Willianlsz1/aquasense/docs/GUIA_MESTRE.md

# Guia mestre do AquaSense

O documento mestre é o texto do TCC **AquaSense_TCC_v6.7_ABNT** (21/10/2026, mantido
fora do repositório). Este guia liga as seções do TCC aos arquivos do código e separa o
que já foi comprovado do que é especificação ou plano.

## O que o TCC apresenta

| Parte do TCC | Situação | Onde está no repositório |
|---|---|---|
| Protótipo V1 — bancada (seção 4.1.1) | Montado e validado em 12/09/2026 | `firmware/aquasense_hc_sr04/`, [validação](VALIDACAO_BANCADA_2026-09-12.md) |
| Protótipo V2 — tubo de acrílico (seção 4.1.2) | Montado, conforme o TCC; falta calibrar o sensor para iniciar os ensaios com água | [roteiro de ensaios](ENSAIOS_V2.md) |
| UCT comercial (seções 4.2 a 4.5) | Especificação; não montada | `firmware/referencia_uct/` (referência, sem ensaio) |
| Software e nuvem (seção 4.6) | Publicado e com testes locais | `cloudflare-worker/`, `index.html`, `relatorio.html`, `assets/` |
| Empresa e identidade visual (capítulo 2 e Apêndice E) | WIM é empresa fictícia da equipe; marca aplicada ao painel | `index.html` |
| Manual, manutenção e finanças (capítulos 5 a 7, 9 e 10) | Somente no texto do TCC | — |
| Mercado (capítulo 8 e Apêndice D) | Fontes conferidas; questionário não aplicado | [validação de mercado](VALIDACAO_MERCADO.md) |

Os protótipos e a UCT compartilham a lógica do firmware (fila, envio, faixas),
o servidor e o painel. O protótipo usa um sketch único; a UCT, os fontes em
`firmware/referencia_uct/`. Mudam o sensor, a comunicação, a energia e a proteção.

## Cenário financeiro do TCC

O cenário de referência é a operação completa de cerca de 100 pontos (premissa P2,
seção 9.3): investimento de R$ 750.000, economia líquida de R$ 425.600 por ano (71% do
custo atual) e payback de cerca de 21 meses. A implantação pode começar por um piloto
de 20 pontos: R$ 150.000, R$ 85.120 por ano e o mesmo payback (seção 9.3.2).

Só o custo da ordem de R$ 600 mil por ano vem do desafio. O número de pontos, o preço e
a composição do custo são estimativas dos autores, e nada disso foi medido em campo.

## Medição e escala do V1

O HC-SR04 mede distância até um alvo. O firmware usa a mediana de cinco tentativas
e converte a distância em nível equivalente: `max(0, 40 - distancia_cm) * 0,5`.
Distância de 20 cm corresponde a 10 m didáticos. O valor exibido não é uma coluna
real de dez metros nem uma medição direta de poropressão.

Faixas: NORMAL abaixo de 12 m, ATENÇÃO a partir de 12 m e CRÍTICO a partir de 15 m,
com histerese de 0,2 m na descida. São valores de demonstração; em campo, os limites
de cada instrumento vêm da geotecnia do cliente.

Ausência de eco válido é FALHA SENSOR: o último valor pode servir de referência,
mas não é enviado como amostra nova.

## Cadeia de dados

1. O ESP32 lê o sensor, classifica a faixa e prepara o envio.
2. `POST /ingest` autentica o dispositivo e valida o conteúdo.
3. O D1 guarda as leituras com horário de medição (`ts`) e de recepção (`recebido_em`).
4. A cada minuto, o motor de alertas avalia nível, taxa de variação e comunicação;
   estados e eventos ficam no KV.
5. O painel consulta `/ultimos`, `/dados`, `/alerts` e `/config` a cada dez segundos.

O frescor usa a recepção; sem recepção por mais de 120 s, o ponto aparece como
SEM SINAL. A taxa de variação usa o horário da medição.

## Painel web

- Resumo no topo (frase e indicadores de alerta, sem sinal e última recepção),
  calculado das últimas leituras. Leitura antiga conta como SEM SINAL; falha da
  API aparece como "não confirmado", nunca como rede normal.
- Tabela de instrumentos por prioridade: nível sobre a escala com os limites,
  folga até a atenção, tendência de 24 h, taxa, recepção e disponibilidade.
  Gráfico da rede, mapa ilustrativo e ocorrências recentes.
- Instrumento: quadro de incidente em atenção/crítico, comunicação, cadastro
  editável (salvo no navegador) e som do alarme crítico com opção de silenciar.
- Leitura atual, origem do dado, última recepção e condição do ponto.
- Gráficos de 24h, 7d, 30d e 90d com média, pico e lacunas visíveis.
- Eventos do servidor (até 50 da rede) como única lista de ocorrências.
- Exportação CSV, Excel e relatório PDF (`relatorio.html`); o PDF fica bloqueado
  na simulação.
- Demonstração só no endereço `?demo`, identificada na tela e nas exportações.
  O endereço normal não tem simulação; falha da API mostra indisponibilidade.
- Tema claro e escuro, com a preferência salva.

## O que foi comprovado

| Evidência | Data | Limite |
|---|---|---|
| Faixas, falha de eco, recuperação e HTTP 204 na bancada | 12/09/2026 | Sem régua: não mede exatidão. |
| OLED exibiu FALHA SENSOR | 12/09/2026 | O display apagou depois, no mesmo dia; substituído pelo TFT. |
| TFT ST7789 com as quatro faixas e tela de campo | 27/09/2026 | Conferência por fotos, sem água no tubo. |
| Queda de rede (12 min) e perda de sinal (18 min) | 27/09/2026 | Bancada; ~50 s perdidos no instante da queda. [Ensaios](ENSAIOS_V2.md). |
| HTTPS com certificado do servidor validado | 27/09/2026 | Depende de NTP e das raízes gravadas no firmware. |
| Painel e Worker publicados | 13/09/2026 | Publicado não significa disponível hoje. A cota diária do D1 já bloqueou consultas. |
| Testes automatizados | 06/11/2026 | 47/47 aprovados localmente (`npm test`). O TCC v6.7 cita 49: dois testes saíram em 14/10/2026 com o gerador do sketch único. |

## Limites conhecidos

- O buffer do V1 fica em RAM: até 120 envios, cerca de 20 minutos. Quando lota,
  descarta o mais antigo; um reinício perde as pendências. A UCT prevê flash.
- O protótipo não usa LEDs nem buzzer: o estado aparece no display TFT e no painel.
- Dados brutos ficam retidos por 180 dias; dias anteriores viram resumos diários,
  ainda sem consulta no painel.
- Os índices da migração 0004 reduziram as consultas ao D1 no código; a economia
  real em produção ainda não foi medida.

## Como demonstrar

Apresentar o problema, mostrar a distância física e a escala, mover o alvo (ou a
água, no V2) pelas faixas, consultar histórico e exportação e explicar SEM SINAL e
simulação. Registrar data, firmware e o que foi observado.
