Willianlsz1/aquasense/docs/CRITERIOS_UI_OPERACIONAL.md

# AquaSense — critérios do painel operacional

## Escopo

Aplicação no painel principal (`index.html`). Preserva mapa, gráficos, histórico e
exportações. O sistema é um protótipo didático; esta revisão não certifica conformidade
com normas nem transforma a leitura de um instrumento em avaliação de segurança.

## Referências e decisões

- [ISA-101 — visão pública da norma](https://www.isa.org/standards-and-publications/isa-standards/isa-101-standards):
  hierarquia e compreensão pelo operador. Rede primeiro, instrumento selecionado,
  leitura e tendência, condição e registros. Superfícies neutras e destaque das exceções.
- [ISA-18 — gestão de alarmes](https://www.isa.org/standards-and-publications/isa-standards/isa-18-series-of-standards):
  separar condição presente de registros históricos. As ocorrências da sessão não são
  uma lista de alarmes ativos. Não há implementação completa de reconhecimento,
  supressão, racionalização ou ciclo de vida de alarmes.
- [Vista Data Vision — interface](https://help.vistadatavision.com/web-interface):
  referência funcional para mapa, tendências, registros e exportações.
- [Sixense — plataformas de monitoramento](https://www.sixense-group.com/en/services/monitoring-testing/monitoring-software-platform):
  referência para leitura conjunta de localização, dados e eventos.

As páginas públicas orientam o projeto; não substituem o texto integral das normas.
Não se adotam percentuais de cor ou taxas de alarme como exigências universais.

## Comportamentos verificáveis

1. O endereço normal só usa a fonte real e não oferece simulação. Erro de API não
   aciona simulação.
2. A demonstração existe apenas em `index.html?demo` (decisão de 23/10/2026: separar
   demonstração de operação). Fica identificada na faixa, no status e nas
   exportações; o PDF real fica bloqueado nesse modo.
3. Trocar a fonte limpa leituras e séries anteriores. Falha de consulta deixa a condição
   atual sem confirmação e identifica valores anteriores como referência.
4. As posições do mapa são ilustrativas. Decisão da equipe (25/09/2026): o painel
   usa linguagem de produto, sem avisos de "didático"; a indicação de SIMULAÇÃO,
   SEM SINAL e "não confirmado" permanece obrigatória.
5. O histórico do servidor consulta `/alerts`: até 50 registros da rede, filtrados
   pelo instrumento selecionado. Não equivale a arquivo completo ou imutável de auditoria.
6. CSV de alertas identifica origem, filtro, horário local/UTC e eventual cache.
7. CSV/Excel de leituras usam os intervalos disponíveis; não são anunciados como
   exportação integral de amostras brutas.
8. O gráfico posiciona dados no tempo, interrompe a linha nas lacunas e não preenche
   essas lacunas com área colorida. Períodos longos incluem data nos rótulos.
9. A visão geral é uma tabela ordenada por prioridade. O nível aparece sobre uma
   escala com faixas neutras e limites marcados; a cor só aparece fora do normal.
10. Ocorrências: no monitoramento real, só os registros do servidor; na demonstração,
    as transições da sessão. Não há lista paralela de "eventos da sessão".
11. Instrumento em atenção ou crítico abre um quadro de incidente (desde quando, pico,
    tendência, vizinhos e o que fazer). Não há reconhecimento de alarme com registro:
    isso exige login e gravação no servidor.
12. Crítico toca um som no navegador a cada 20 s, com opção de silenciar. Não substitui
    aviso fora da tela (e-mail, mensagem), que o projeto não implementa.
13. Nome e cadastro do instrumento são editáveis e ficam salvos no navegador. O código
    enviado pela UCT não muda. Limites seguem iguais para todos os instrumentos.

## Limitações

Acesso local à API e aos mapas depende da rede e das permissões de origem do servidor.
Testes locais e simulação não validam bancada, serviço publicado ou instrumentação industrial.
Limiares precisam ser definidos pelo responsável pelo caso de uso. Firmware/OLED não
fazem parte desta revisão. A versão revisada foi publicada em 13/09/2026.

## Conferência em 13/09/2026

- `/ultimos` respondeu HTTP 200. O cabeçalho `Access-Control-Allow-Origin` permite
  `https://willianlsz1.github.io`, não a origem da prévia local. Isso explica a falha
  de acesso no navegador local; não foi necessário alterar CORS em produção.
- Uma prévia temporária, restrita a `127.0.0.1`, intermediou somente consultas GET
  aos endpoints existentes. Os arquivos do produto mantêm a URL original da API.
- O painel consultou os dados reais e exibiu `SEM SINAL`: última recepção de PZ-01
  em 12/09/2026 às 17:09:22, horário local. Não houve comprovação de nova medição física.
- A consulta retornou 50 eventos para PZ-01. Selecionar PZ-02 exibiu zero eventos
  dentro desse recorte, sem afirmar ausência de eventos fora dos últimos 50.
- Testes de exportação verificam 72 intervalos completos, classificação pelo máximo
  mesmo com média normal, e identificação de simulação em CSV e Excel.
