Willianlsz1/aquasense/docs/img/painel_api_indisponivel.png

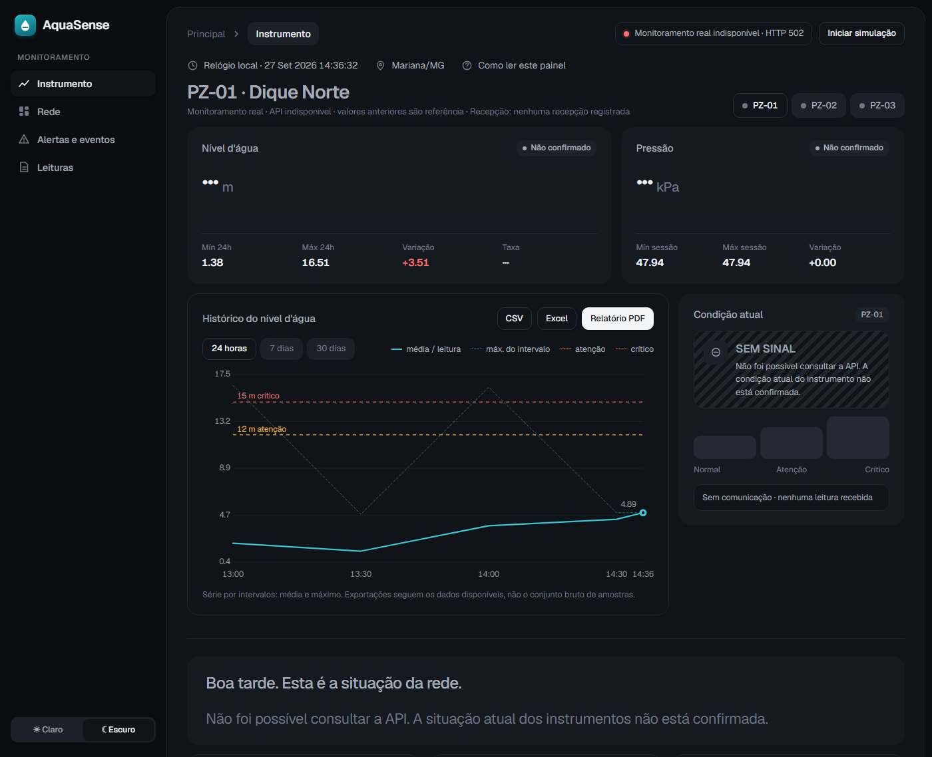
docs/img/painel_api_indisponivel.png
