Willianlsz1/aquasense/docs/img/painel_eventos.png

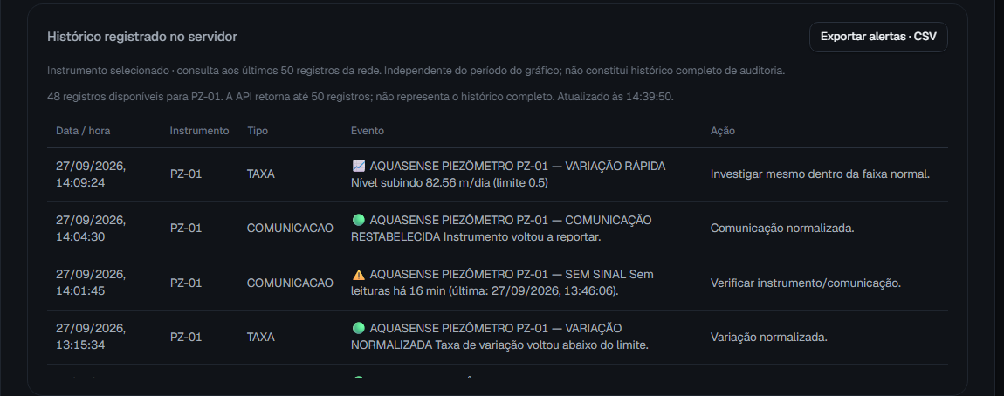
docs/img/painel_eventos.png
