Willianlsz1/aquasense/docs/img/painel_rede.png

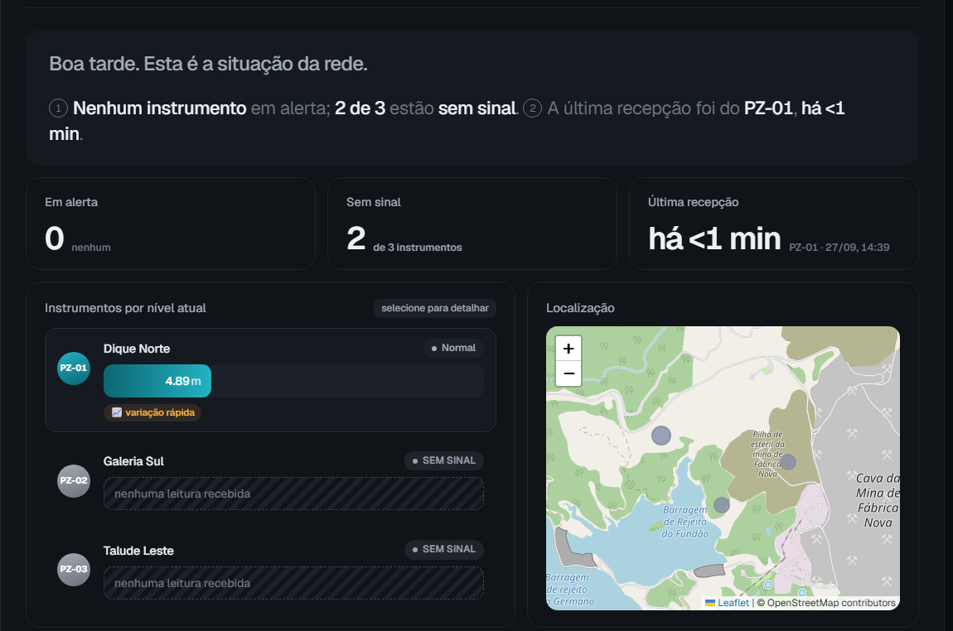
docs/img/painel_rede.png
