Willianlsz1/aquasense/firmware/aquasense_hc_sr04/aquasense_hc_sr04.ino

// AQUASENSE — protótipo V1/V2: ESP32 + HC-SR04 + TFT ST7789
// Lê o nível a cada 1 s, mostra na tela e no Serial, e envia ao servidor a cada 10 s.
// Sem rede, guarda até 120 leituras (~20 min) e envia quando a rede volta.
//
// Arduino IDE: placa "ESP32 Dev Module"; bibliotecas "Adafruit GFX" e
// "Adafruit ST7735 and ST7789". Preencha as credenciais abaixo SÓ na sua cópia
// local e não publique o arquivo preenchido (contém senha e chave).

#include <SPI.h>
#include <Adafruit_GFX.h>
#include <Adafruit_ST7789.h>
#include <WiFi.h>
#include <HTTPClient.h>
#include <WiFiClientSecure.h>
#include <time.h>

// ===== CREDENCIAIS (preencha antes de gravar) =====
#define WIFI_SSID     "SUA_REDE_WIFI"
#define WIFI_PASS     "SUA_SENHA_WIFI"
#define SERVER_URL    "https://piezometro-worker.SEU-SUBDOMINIO.workers.dev/ingest"
#define DEVICE_KEY    "troque-esta-chave"   // a mesma DEVICE_KEY do Worker
#define PIEZOMETRO_ID "PZ-01"

// ===== FAIXAS DE ALERTA (m) =====
#define NIVEL_ATENCAO 12.0   // a partir daqui: ATENCAO
#define NIVEL_CRITICO 15.0   // a partir daqui: CRITICO

// ===== SENSOR HC-SR04 =====
#define PIN_TRIG 5
#define PIN_ECHO 18             // ECHO é 5 V: manter o divisor 1k/2k
#define ALTURA_REF_CM   40.0    // distância do sensor ao nível zero
#define ESCALA_M_POR_CM  0.5    // escala didática: 1 cm = 0,5 m
#define DIST_MIN_CM  3.0
#define DIST_MAX_CM  400.0

// ===== TELA TFT ST7789 (SPI, 320x240 deitada) =====
#define TFT_SCK  14   // pino SCK da tela
#define TFT_MOSI 13   // pino SDA da tela
#define TFT_CS   25
#define TFT_DC   27
#define TFT_RST  26
#define TFT_LARGURA 320

// ===== TEMPOS =====
#define INTERVALO_LEITURA   1000UL    // 1 s
#define INTERVALO_ENVIO     10000UL   // 10 s
#define INTERVALO_NTP       300000UL  // ressincroniza o relógio a cada 5 min
#define INTERVALO_RECONEXAO 60000UL   // insiste no Wi-Fi a cada 1 min
#define FUSO_HORARIO_SEG    (-3 * 3600)  // hora de Brasília na tela; o envio usa UTC
#define BUFFER_MAX          120       // ~20 min de leituras sem rede

// Faixas: também escolhem a cor da tarja na tela
enum Faixa { NORMAL, ATENCAO, CRITICO, FALHA };

// ===== CERTIFICADOS RAIZ (valida o servidor HTTPS) =====
static const char CA_RAIZES[] = R"PEM(
-----BEGIN CERTIFICATE-----
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
-----END CERTIFICATE-----
-----BEGIN CERTIFICATE-----
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
/q4AaOeMSQ+2b1tbFfLn
-----END CERTIFICATE-----
-----BEGIN CERTIFICATE-----
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
bP6MvPJwNQzcmRk13NfIRmPVNnGuV/u3gm3c
-----END CERTIFICATE-----
-----BEGIN CERTIFICATE-----
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
6WLAYv7YTVWW4tAR+kg0Eeye7QUd5MjWHYbL
-----END CERTIFICATE-----
-----BEGIN CERTIFICATE-----
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
-----END CERTIFICATE-----
-----BEGIN CERTIFICATE-----
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
-----END CERTIFICATE-----
)PEM";

// ===== ESTADO =====
SPIClass spiTela(HSPI);
Adafruit_ST7789 tft(&spiTela, TFT_CS, TFT_DC, TFT_RST);

float nivelM = 0;              // último nível válido (m)
float distanciaCm = -1;        // última distância medida; -1 = sem eco
bool leituraValida = false;    // a leitura deste ciclo veio do sensor?
bool jaTeveLeitura = false;    // houve alguma leitura válida desde o início?
Faixa faixa = FALHA;

bool ntpOk = false;
int ultimoCodigoHttp = 0;      // 0 = ainda não enviou; 204 = aceito; <0 = sem conexão
unsigned long ultimoEnvioOkMs = 0;
unsigned long ultimaLeitura = 0, ultimoEnvio = 0, ultimoNtp = 0, ultimaReconexao = 0;

String fila[BUFFER_MAX];
int filaCount = 0;

// ===== SENSOR =====
float medirDistanciaCm() {
  digitalWrite(PIN_TRIG, LOW);
  delayMicroseconds(2);
  digitalWrite(PIN_TRIG, HIGH);
  delayMicroseconds(10);
  digitalWrite(PIN_TRIG, LOW);
  unsigned long duracao = pulseIn(PIN_ECHO, HIGH, 30000UL);  // espera até 30 ms
  return duracao / 58.0;                                     // µs -> cm (0 = sem eco)
}

// Mediana de 5 tentativas, ignorando as fora da faixa útil. -1 = nenhuma válida.
float medirMedianaCm() {
  float v[5];
  int n = 0;
  for (int i = 0; i < 5; i++) {
    float d = medirDistanciaCm();
    if (d >= DIST_MIN_CM && d <= DIST_MAX_CM) v[n++] = d;
    delay(30);
  }
  if (n == 0) return -1;
  for (int i = 1; i < n; i++)            // ordena (poucos valores)
    for (int j = i; j > 0 && v[j - 1] > v[j]; j--) {
      float t = v[j]; v[j] = v[j - 1]; v[j - 1] = t;
    }
  return v[n / 2];
}

void lerSensor() {
  distanciaCm = medirMedianaCm();
  leituraValida = distanciaCm > 0;
  if (!leituraValida) {      // falha: mantém o último nível, mas não o envia como novo
    faixa = FALHA;
    return;
  }
  nivelM = max(0.0, ALTURA_REF_CM - distanciaCm) * ESCALA_M_POR_CM;
  jaTeveLeitura = true;
  if (nivelM < NIVEL_ATENCAO) faixa = NORMAL;
  else if (nivelM < NIVEL_CRITICO) faixa = ATENCAO;
  else faixa = CRITICO;
}

// ===== REDE =====
void conectarWiFi() {
  Serial.print("Conectando ao Wi-Fi \"" WIFI_SSID "\"");
  WiFi.setAutoReconnect(true);
  WiFi.begin(WIFI_SSID, WIFI_PASS);
  unsigned long inicio = millis();
  while (WiFi.status() != WL_CONNECTED && millis() - inicio < 15000) {
    delay(500);
    Serial.print(".");
  }
  if (WiFi.status() == WL_CONNECTED) {
    Serial.print(" OK! IP: ");
    Serial.println(WiFi.localIP());
  } else {
    Serial.println(" FALHOU - segue medindo e guardando na fila.");
  }
}

void sincronizarNTP() {
  if (WiFi.status() != WL_CONNECTED) return;
  Serial.print("Sincronizando relogio (NTP)");
  configTime(0, 0, "pool.ntp.org");
  unsigned long inicio = millis();
  while (time(nullptr) < 1000000000 && millis() - inicio < 10000) {
    delay(500);
    Serial.print(".");
  }
  ntpOk = time(nullptr) >= 1000000000;
  Serial.println(ntpOk ? " OK!" : " FALHOU - envio sem horario local.");
}

// Guarda a leitura atual na fila; se cheia, descarta a mais antiga.
void guardarNaFila() {
  char item[96];
  if (ntpOk)
    snprintf(item, sizeof(item), "{\"piezometro\":\"" PIEZOMETRO_ID "\",\"nivel_agua\":%.3f,\"ts\":%ld}",
             nivelM, (long)time(nullptr));
  else
    snprintf(item, sizeof(item), "{\"piezometro\":\"" PIEZOMETRO_ID "\",\"nivel_agua\":%.3f}", nivelM);

  if (filaCount >= BUFFER_MAX) {
    for (int i = 1; i < BUFFER_MAX; i++) fila[i - 1] = fila[i];
    filaCount = BUFFER_MAX - 1;
    Serial.println("Fila cheia - leitura mais antiga descartada");
  }
  fila[filaCount++] = item;
}

// Envia a fila inteira num único POST; só esvazia se o servidor aceitar (HTTP 204).
void enviarFila() {
  if (filaCount == 0) return;
  if (WiFi.status() != WL_CONNECTED) {
    Serial.printf("Wi-Fi offline - %d leitura(s) na fila\n", filaCount);
    if (millis() - ultimaReconexao >= INTERVALO_RECONEXAO) {
      ultimaReconexao = millis();
      WiFi.reconnect();
    }
    return;
  }
  if (!ntpOk) sincronizarNTP();  // a rede voltou: tenta recuperar o relógio

  String corpo = "{\"leituras\":[";
  for (int i = 0; i < filaCount; i++) {
    if (i > 0) corpo += ",";
    corpo += fila[i];
  }
  corpo += "]}";

  WiFiClientSecure cliente;
  cliente.setCACert(CA_RAIZES);
  cliente.setHandshakeTimeout(5);  // s: rede ruim não pode travar a medição por muito tempo
  HTTPClient http;
  http.begin(cliente, SERVER_URL);
  http.addHeader("Content-Type", "application/json");
  http.addHeader("X-Device-Key", DEVICE_KEY);
  http.setConnectTimeout(3000);
  http.setTimeout(5000);

  ultimoCodigoHttp = http.POST(corpo);
  if (ultimoCodigoHttp == 204) {
    ultimoEnvioOkMs = millis();
    Serial.printf("Servidor: %d leitura(s) enviadas (HTTP 204)\n", filaCount);
    filaCount = 0;
  } else {
    Serial.printf("Servidor: falha (HTTP %d) - %d leitura(s) na fila\n", ultimoCodigoHttp, filaCount);
  }
  http.end();
}

// ===== TELA =====
// Escreve uma linha, completando com espaços para apagar o texto anterior.
void linha(const char* texto, uint8_t tamanho, int16_t y, uint16_t cor, uint16_t fundo) {
  char buf[32];
  snprintf(buf, sizeof(buf), "%-25.25s", texto);
  tft.setTextSize(tamanho);
  tft.setTextColor(cor, fundo);
  tft.setCursor(8, y);
  tft.print(buf);
}

void desenharFundo() {
  tft.fillScreen(ST77XX_BLACK);
  tft.fillRect(0, 0, TFT_LARGURA, 32, ST77XX_BLUE);
}

void mostrarTelaInicio() {
  tft.fillScreen(ST77XX_BLACK);
  tft.setTextColor(ST77XX_CYAN);
  tft.setTextSize(4);
  tft.setCursor(52, 60);
  tft.print("AquaSense");
  tft.setTextColor(ST77XX_WHITE);
  tft.setTextSize(2);
  tft.setCursor(64, 120);
  tft.print("Nivel de agua em");
  tft.setCursor(94, 144);
  tft.print("piezometros");
  tft.setCursor(88, 196);
  tft.print("Iniciando...");
  delay(2000);
  desenharFundo();
}

// Tarja inferior colorida; só redesenha quando a faixa muda (evita piscar).
void mostrarTarja() {
  static int faixaDesenhada = -1;
  if (faixa == faixaDesenhada) return;
  faixaDesenhada = faixa;

  const char* rotulo = "NORMAL";
  uint16_t fundo = ST77XX_GREEN, cor = ST77XX_BLACK;
  if (faixa == ATENCAO)      { rotulo = "ATENCAO";      fundo = ST77XX_YELLOW; }
  else if (faixa == CRITICO) { rotulo = "CRITICO!";     fundo = ST77XX_RED;     cor = ST77XX_WHITE; }
  else if (faixa == FALHA)   { rotulo = "FALHA SENSOR"; fundo = ST77XX_MAGENTA; cor = ST77XX_WHITE; }

  tft.fillRect(0, 160, TFT_LARGURA, 80, fundo);
  tft.setTextSize(4);  // 24 px por caractere
  tft.setTextColor(cor);
  tft.setCursor(max(0, (TFT_LARGURA - (int)strlen(rotulo) * 24) / 2), 184);
  tft.print(rotulo);
}

void mostrarTela() {
  char buf[40];

  char hora[9] = "--:--:--";
  if (ntpOk) {
    time_t t = time(nullptr) + FUSO_HORARIO_SEG;
    struct tm tmHora;
    gmtime_r(&t, &tmHora);
    strftime(hora, sizeof(hora), "%H:%M:%S", &tmHora);
  }
  snprintf(buf, sizeof(buf), "%-16s%s", PIEZOMETRO_ID " AQUASENSE", hora);
  linha(buf, 2, 9, ST77XX_WHITE, ST77XX_BLUE);

  // Em falha, mostra o último nível como "Ultimo", nunca como medição atual
  if (!jaTeveLeitura) snprintf(buf, sizeof(buf), "Nivel: ---");
  else snprintf(buf, sizeof(buf), leituraValida ? "Nivel: %.2f m" : "Ultimo: %.2f m", nivelM);
  linha(buf, 3, 42, ST77XX_WHITE, ST77XX_BLACK);

  if (leituraValida) snprintf(buf, sizeof(buf), "Sensor: %.1f cm", distanciaCm);
  else snprintf(buf, sizeof(buf), "Sensor: sem eco");
  linha(buf, 2, 78, ST77XX_CYAN, ST77XX_BLACK);

  snprintf(buf, sizeof(buf), "Limites: %.0f / %.0f m", NIVEL_ATENCAO, NIVEL_CRITICO);
  linha(buf, 2, 102, ST77XX_CYAN, ST77XX_BLACK);

  // Comunicação: amarelo quando há problema
  bool problema = true;
  long rssi = WiFi.RSSI();
  if (WiFi.status() != WL_CONNECTED)
    snprintf(buf, sizeof(buf), "SEM WI-FI  Fila %d %dmin", filaCount, filaCount * 10 / 60);
  else if (ultimoCodigoHttp < 0)
    snprintf(buf, sizeof(buf), "SEM SERVIDOR  Fila %d", filaCount);
  else if (ultimoCodigoHttp != 0 && ultimoCodigoHttp != 204)
    snprintf(buf, sizeof(buf), "ERRO SERV %d  Fila %d", ultimoCodigoHttp, filaCount);
  else {
    problema = false;
    unsigned long idade = (millis() - ultimoEnvioOkMs) / 1000;
    if (ultimoCodigoHttp == 0) snprintf(buf, sizeof(buf), "WiFi %lddBm  Aguardando", rssi);
    else if (idade < 100)      snprintf(buf, sizeof(buf), "WiFi %lddBm  Envio OK %lus", rssi, idade);
    else                       snprintf(buf, sizeof(buf), "WiFi %lddBm  Envio OK %lum", rssi, idade / 60);
  }
  linha(buf, 2, 130, problema ? ST77XX_YELLOW : ST77XX_WHITE, ST77XX_BLACK);

  mostrarTarja();
}

// ===== SERIAL =====
void mostrarSerial() {
  Serial.println("---------------------------------------");
  if (leituraValida) {
    Serial.printf("Nivel: %.2f m   Distancia: %.1f cm\n", nivelM, distanciaCm);
  } else {
    Serial.println("FALHA SENSOR - sem eco; leitura nao sera enviada.");
    if (jaTeveLeitura) Serial.printf("Ultimo nivel conhecido: %.2f m\n", nivelM);
    else Serial.println("Nenhuma leitura valida desde o inicio");
  }
  const char* status[] = {"NORMAL", "ATENCAO", "CRITICO", "FALHA SENSOR"};
  Serial.printf("Status: %s   Fila: %d leitura(s)\n", status[faixa], filaCount);
}

// ===== INÍCIO E REPETIÇÃO =====
void setup() {
  Serial.begin(115200);
  delay(1000);
  Serial.println("=== AQUASENSE - instrumento " PIEZOMETRO_ID " ===");

  pinMode(PIN_TRIG, OUTPUT);
  pinMode(PIN_ECHO, INPUT);
  digitalWrite(PIN_TRIG, LOW);

  spiTela.begin(TFT_SCK, -1, TFT_MOSI, TFT_CS);
  tft.init(240, 320);
  tft.invertDisplay(false);  // este módulo mostrava as cores invertidas
  tft.setRotation(1);
  tft.setTextWrap(false);
  mostrarTelaInicio();

  conectarWiFi();
  sincronizarNTP();
  ultimoNtp = millis();
  Serial.println("Monitoramento iniciado.");
}

void loop() {
  unsigned long agora = millis();

  if (agora - ultimaLeitura >= INTERVALO_LEITURA) {
    ultimaLeitura = agora;
    lerSensor();
    mostrarSerial();
    mostrarTela();
  }

  if (agora - ultimoEnvio >= INTERVALO_ENVIO) {
    ultimoEnvio = agora;
    if (leituraValida) guardarNaFila();
    enviarFila();  // pode esperar alguns segundos se a rede estiver ruim
  }

  if (agora - ultimoNtp >= INTERVALO_NTP) {
    ultimoNtp = agora;
    sincronizarNTP();
  }
}
