Willianlsz1/aquasense/(commit log)

2026-07-28 docs: deixa o README apresentável com fotos da demo e seções de segurança e autor
    - Fotos reais do protótipo de bancada e do dashboard durante a demonstração de 28/07
    - Estado do projeto atualizado com a demo em vídeo
    - Nova seção Segurança: onde vivem os segredos e por quê
    - Nova seção Autor com contato e posicionamento honesto do protótipo
    - Árvore de estrutura atualizada com docs/img/
2026-07-28 docs: atualiza referências do nome do repositório para aquasense
    O repositório foi renomeado de piezometro-teste para aquasense no GitHub.
    Links antigos do repositório redirecionam automaticamente; a URL do GitHub
    Pages muda para /aquasense.
2026-07-28 segurança: restringe CORS à origem do dashboard publicado
    ALLOWED_ORIGIN passa de "*" para https://willianlsz1.github.io, alinhando o
    Worker com o que a seção de Segurança do README documenta. Não afeta o ESP32
    (dispositivos não passam por CORS) nem os endpoints em si — só restringe qual
    origem de navegador pode ler a API.
2026-08-22 docs: esclarece contrato de dados stale
2026-08-22 docs: planeja remoção de canais externos
2026-08-22 test: define contrato de telemetria stale
2026-08-22 chore: remove configuração de Telegram e Twilio
2026-08-22 fix: não deriva indicadores de leitura stale
2026-08-22 fix: preserva borda de taxa durante perda de sinal
2026-09-09 docs: define fluxo simples de trabalho do TCC
2026-09-11 fix(firmware): signal sensor failure in HC-SR04 prototype
    [piezometro_core.h, sketch_demo_hc_sr04.ino, sketch_uct_4a20ma.ino, tela.h]
2026-09-12 fix(dashboard): preserve alerts when switching history period
2026-09-12 fix(firmware): verify OLED I2C response before reporting success
    [aquasense_hc_sr04.ino, tela_ssd1306.h]
2026-09-12 docs: record OLED I2C diagnostic failure
2026-09-14 docs: alinha AquaSense ao escopo demonstravel de bancada
2026-09-25 docs: alinha repositorio ao TCC v5 e remove material obsoleto
    Remove planos encerrados, notas internas, proposta de UI e pagina de
    alerta sem link, e variantes de firmware (Wokwi/JSN-SR04T) fora do TCC.
    Unifica guia mestre e escopo, reescreve o README conforme o documento
    mestre e adiciona o roteiro de ensaios do prototipo V2.
2026-09-25 feat(dashboard): novo layout com menu lateral e resumo da rede
    Aplica o modelo visual aprovado: menu lateral, conteudo em painel
    arredondado, fonte Geist, resumo da rede calculado das ultimas leituras,
    instrumentos em barras, balao de leitura no grafico e seletor de tema
    claro/escuro. Mantem SEM SINAL, simulacao identificada, falha da API
    como nao confirmada e todos os identificadores usados pelo codigo.
    Substitui styles.css, operacao.css e tema.css por painel.css.
2026-09-25 feat(dashboard): leitura do instrumento primeiro e linguagem de produto
    Nivel, pressao e grafico passam ao topo, com seletor rapido de
    instrumento; resumo da rede, barras e mapa descem. Remove mencoes a
    "didatico" e "demonstracao" da interface, mantendo SIMULACAO, SEM SINAL
    e "nao confirmado". Corrige o destaque do menu e o ponto medio da Geist.
2026-09-27 refactor(firmware): remove LEDs e buzzer, que o protótipo não usa
    O núcleo deixa de configurar e acionar os pinos 25, 26, 32 e 33; o estado
    continua no OLED, no serial e no painel. O sketch de uma aba foi gerado de
    novo. Os três firmwares compilam para esp32:esp32:esp32 (core 3.3.11).
    [aquasense_hc_sr04.ino, piezometro_core.h, piezometro_deep_sleep.h, sketch_uct_4a20ma.ino]
2026-09-27 docs: reorganiza README com guia de montagem, mapa do firmware e licença MIT
    - README.md (antes readme.md) com fotos, arquitetura, materiais do V1,
    esquema de ligação, passos para gravar o firmware e convenção de commits.
    - firmware/README.md indica qual arquivo abrir; o histórico de bancada do
    antigo UMA_ABA.md passa para docs/REGISTRO_FIRMWARE.md.
    - Licença MIT; captura do painel em tema claro no lugar da imagem antiga.
2026-09-27 feat(firmware): troca OLED SSD1306 pelo TFT ST7789 240x320 (SPI)
    Tela em HSPI: SCK 14, SDA 13, CS 25, DC 27, RST 26. HC-SR04 segue em 5/18.
2026-09-27 fix(firmware): desliga inversão de cores do TFT ST7789
    Na bancada o módulo exibiu cores invertidas (preto como branco).
    [aquasense_hc_sr04.ino, tela_st7789.h]
2026-09-27 docs: registra ensaio de bancada do TFT ST7789
2026-09-27 docs: registra ensaio da faixa FALHA SENSOR no TFT
2026-09-27 docs: registra ensaio de queda de rede com buffer do ESP32
2026-09-27 feat(firmware): tela de campo com hora, envio e fila; envio sem travar
    - Linha de comunicação mostra Wi-Fi (dBm), idade do último envio aceito,
    erro do servidor e fila pendente, em vez de "DEMO WiFi:OK".
    - Título com instrumento e hora local; linhas do sensor e limites.
    - Tempo limite de conexão 3 s e handshake 5 s para a queda de rede não
    parar a medição; reconexão forçada só a cada 1 min.
2026-09-27 docs: registra ensaio de perda de sinal (evento em 15,6 min e retorno)
2026-09-27 fix(firmware): valida o certificado HTTPS do servidor
    Troca setInsecure() por setCACert() com raízes ISRG X1/X2 e GTS R1-R4
    (lista Mozilla/certifi), no núcleo e no modo deep sleep.
    [aquasense_hc_sr04.ino, piezometro_core.h, piezometro_deep_sleep.h]
2026-09-27 docs: confirma envio com certificado validado e tela de campo na bancada
2026-09-27 docs: capturas do painel com histórico real e falha de API
2026-09-27 docs: esquema e guia de montagem com o TFT ST7789
2026-09-27 docs: situação atual com TFT e ensaios de 27/09; comentários sem OLED
2026-09-27 docs: validação de mercado em duas camadas, só com fontes conferidas
2026-10-14 refactor(firmware): sketch único e enxuto para o protótipo V1/V2
    O sketch do HC-SR04 deixa de ser gerado e passa a ser o único fonte do
    protótipo (794 -> 497 linhas, 135 delas certificados). Remove a camada de
    tela genérica, campos de pressão/temperatura, I2C e o OLED SSD1306.
    Comportamento mantido: mediana de 5, envio a cada 10 s, fila de 120,
    HTTPS validado, falha de sensor sem envio. UCT 4-20 mA, deep sleep e
    núcleo antigo vão intactos para firmware/referencia_uct/.
2026-10-23 feat(painel): identidade do pitch, abas e tubo animado
    O painel passa a usar a marca e o visual do pitch e dos slides: logo
    oficial (gota em três partes), marinho e ciano, Barlow Semi Condensed
    nos números e IBM Plex no texto, nos temas escuro e claro.
    A página única vira quatro abas: Visão geral, Mapa, Instrumento e
    Alertas e eventos (âncoras antigas continuam valendo). A visão geral
    responde primeiro se a rede está bem e ordena os cartões por
    prioridade; cada cartão mostra o tubo com a água no nível atual. A aba
    Instrumento ganha o tubo grande com solo, UCT e limites; o mapa ocupa
    a tela, com satélite, rótulos de valor e lista lateral.
    Lógica de dados, frescor, simulação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
2026-10-23 fix(painel): ajustes encontrados no teste manual
    - simulação envia só nível (sem temperatura/pressão fictícias) e taxa plausível
    - sparkline não estoura a largura da página
    - mapa enquadra os rótulos dos marcadores
    - remove numeração solta no resumo da rede
    - tabela vazia diz que não há leituras no período
    - rótulos do tubo legíveis no tema claro
2026-10-23 fix(mapa): não puxar o mapa de volta e não pedir foto inexistente no zoom alto
2026-10-23 feat(dashboard): painel v2 com tabela da rede, incidente e demonstração
    - visão geral em tabela por prioridade: nível sobre escala com limites, folga,
    tendência de 24 h, taxa, recepção e disponibilidade; gráfico da rede, mapa
    e ocorrências do servidor
    - instrumento com indicadores de folga, quadro de incidente, comunicação,
    cadastro editável (salvo no navegador) e localização
    - som do alarme crítico com opção de silenciar
    - simulação só em index.html?demo, com roteiro e tempo acelerado
    - remove pressão calculada, temperatura e lista de eventos da sessão
    - período de 90 dias no painel e no Worker
2026-11-06 docs: alinha repositório ao TCC v6.7 e ao painel v2
    Atualiza a referência do documento mestre, a situação do V2, a contagem
    de testes (47), a empresa WIM e o cenário financeiro de 100 pontos.
2026-11-06 docs: adiciona seção Meu papel e crédito de desenvolvimento na licença
